nixzee/deco-pad-v1/deco-pad-v1/assembly/bom.xlsx

Designator | Package | Quantity | Designation | Part Number | Cost | Total by Board | Total | Link
R5 | R_0805_2012Metric | 1 | 1K | ERA-6AEB102V | $0.33 | $0.33 | $1.65 | https://www.digikey.com/product-detail/en/panasonic-electronic-components/ERA-6AEB102V/P1-0KDACT-ND/1465947
D18 | LED_0805_2012Metric | 1 | RED | LTST-C171KRKT | $0.28 | $0.28 | $1.40 | https://www.digikey.com/product-detail/en/lite-on-inc/LTST-C171KRKT/160-1427-1-ND/386800
U1 | QFN-44-1EP_7x7mm_P0.5mm_EP5.2x5.2mm | 1 | ATmega32U4-MU | ATMEGA32U4-MU | $3.98 | $3.98 | $19.90 | https://www.digikey.com/product-detail/en/microchip-technology/ATMEGA32U4-MU/ATMEGA32U4-MU-ND/1914603
J1 | PinSocket_2x03_P2.54mm_Vertical | 1 | AVR-ISP-6 | 67997-206HLF | $0.33 | $0.33 | $1.65 | https://www.digikey.com/product-detail/en/amphenol-icc-fci/67997-206HLF/609-3234-ND/1878491
R4,R3 | R_0805_2012Metric | 2 | 22 | ERJ-6GEYJ220V | $0.10 | $0.20 | $1.00 | https://www.digikey.com/product-detail/en/panasonic-electronic-components/ERJ-6GEYJ220V/P22ACT-ND/87316
R9,R8,R7,R6,R11,R10 | R_0805_2012Metric | 6 | 10K | ERA-6AEB103V | $0.33 | $1.98 | $9.90 | https://www.digikey.com/product-detail/en/panasonic-electronic-components/ERA-6AEB103V/P10KDACT-ND/1465971
D17,D16,D15,D14,D13,D12,D11,D10,D9,D8,D7,D6,D5,D4,D3,D2,D1 | D_SOD-123 | 17 | D_Small | 1N4148W-TP | $0.15 | $2.55 | $12.75 | https://www.digikey.com/product-detail/en/micro-commercial-co/1N4148W-TP/1N4148WTPMSCT-ND/717311
C2,C1 | C_0805_2012Metric | 2 | 0.01u | C0805C103J5RAC7210 | $0.10 | $0.20 | $1.00 | https://www.digikey.com/product-detail/en/kemet/C0805C103J5RAC7210/399-17616-1-ND/8572616
Y1 | Crystal_SMD_3225-4Pin_3.2x2.5mm | 1 | 16MHz | NX3225SA-16.000M-STD-CSR-1 | $0.75 | $0.75 | $3.75 | https://www.digikey.com/product-detail/en/ndk-america-inc/NX3225SA-16-000M-STD-CSR-1/644-1049-1-ND/1128921
USB1 | HRO-TYPE-C-31-M-12-HandSoldering | 1 | HRO-TYPE-C-31-M-12 | HRO-TYPE-C-31-M-12 | $0.99 | $0.99 | $4.95 | https://keeb.io/products/usb-c-port-12-pin-hro-type-c-31-m-12
SW2 | SW_SPST_B3S-1000 | 1 | SW_Push | B3S-1000P | $0.65 | $0.65 | $3.25 | https://www.digikey.com/product-detail/en/omron-electronics-inc-emc-div/B3S-1000P/SW836CT-ND/700012
SW1 | RotaryEncoder_Alps_EC11E-Switch_Vertical_H20mm | 1 | EC11 | PEC11L-4115F-S0020 | $2.34 | $2.34 | $11.70 | https://www.digikey.com/product-detail/en/bourns-inc/PEC11L-4115F-S0020/PEC11L-4115F-S0020-ND/4699168
R2,R1 | R_0805_2012Metric | 2 | 5.1K | ERA-6AEB512V | $0.33 | $0.66 | $3.30 | https://www.digikey.com/product-detail/en/panasonic-electronic-components/ERA-6AEB512V/P5-1KDACT-ND/1465964
F1 | Fuse_1206_3216Metric | 1 | 500mA | 0ZCJ0050AF2E | $0.19 | $0.19 | $0.95 | https://www.digikey.com/product-detail/en/bel-fuse-inc/0ZCJ0050AF2E/507-1803-1-ND/4156312
C11,C10 | C_0805_2012Metric | 2 | 20 | CL21B105KAFNNNE | $0.10 | $0.20 | $1.00 | https://www.digikey.com/product-detail/en/samsung-electro-mechanics/CL21B105KAFNNNE/1276-1066-1-ND/3889152
C9,C8,C7,C6,C5 | C_0805_2012Metric | 5 | 0.1u | CL21B104MBCNNNC | $0.10 | $0.50 | $2.50 | https://www.digikey.com/product-detail/en/samsung-electro-mechanics/CL21B104MBCNNNC/1276-2450-1-ND/3890536
C4,C3 | C_0805_2012Metric | 2 | 22p | CL21C220JB61PNC | $0.22 | $0.44 | $2.20 | https://www.digikey.com/product-detail/en/samsung-electro-mechanics/CL21C220JB61PNC/1276-2605-1-ND/3890691
 |  |  |  |  | Total | $16.57 | $82.85
