nixzee/deco-pad-v1/deco-pad-v1/assembly/deco-pad-v1.step

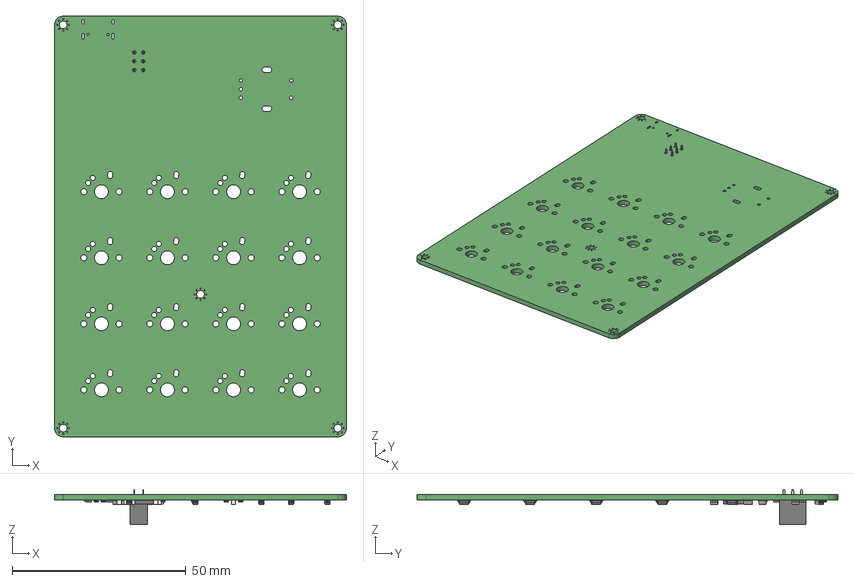
[picture p1: CAD file, 2020-07-16]
deco-pad-v1/assembly/deco-pad-v1.step
84.0 x 121.0 x 10.1 mm
