nixzee/deco-pad-v1/stl/case-top.stl

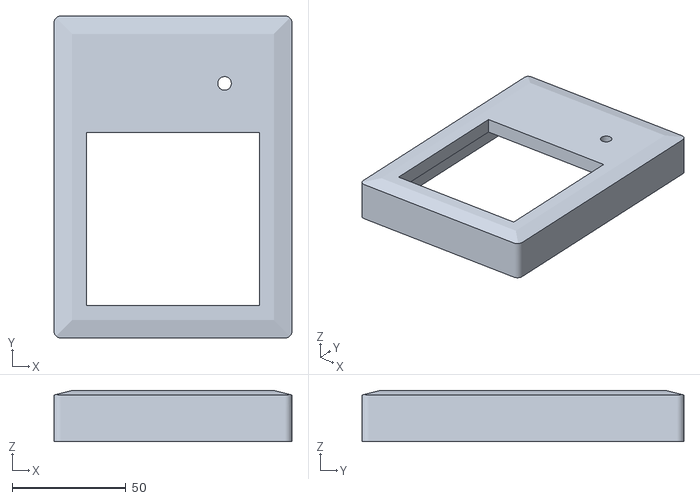
[picture p2: CAD file, 2020-07-27]
stl/case-top.stl
104.8 x 141.8 x 22.5
