nixzee/deco-pad-v1/stl/case-bottom.stl

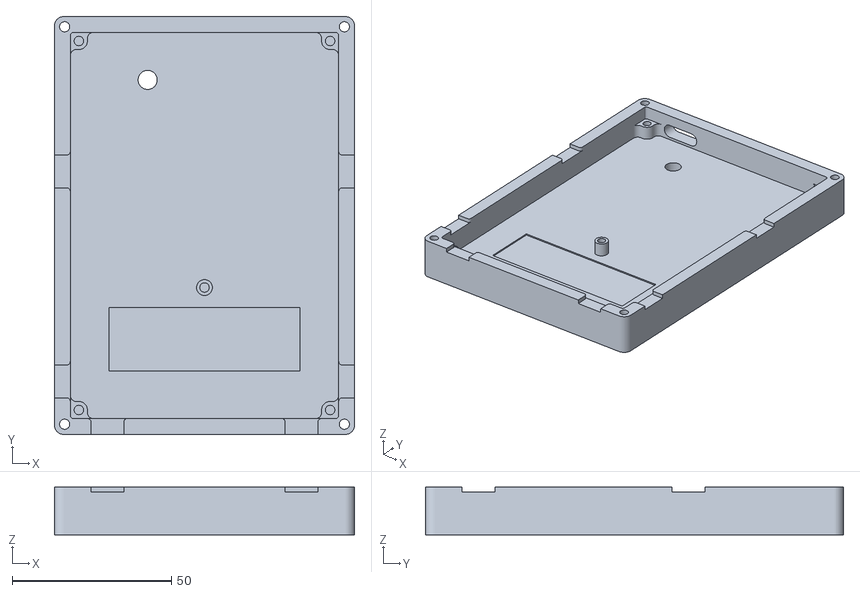
[picture p3: CAD file, 2020-07-27]
stl/case-bottom.stl
94.4 x 131.4 x 15.0
