nixzee/deco-pad-v1/stl/knob.stl

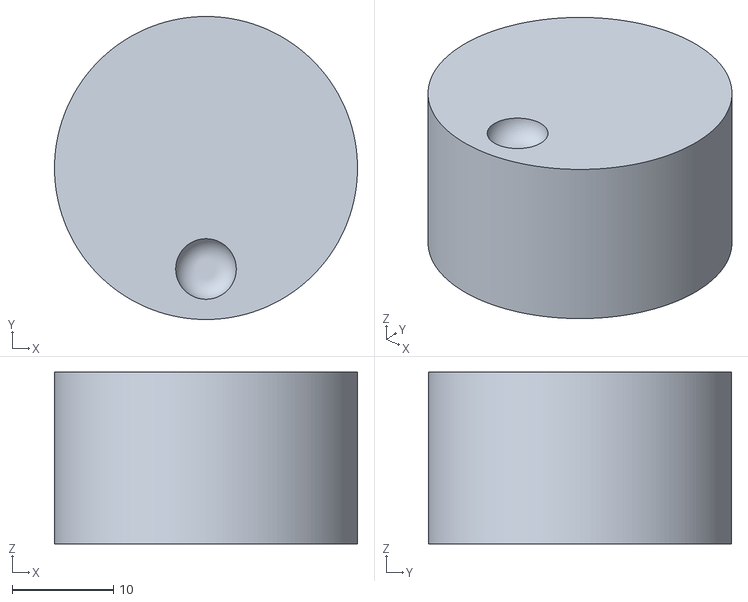
[picture p4: CAD file, 2020-07-27]
stl/knob.stl
30.0 x 30.0 x 17.0
