nixzee/deco-pad-v1/stl/plate.stl

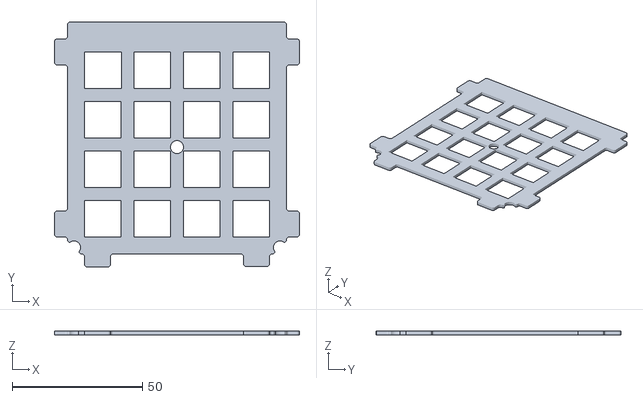
[picture p5: CAD file, 2020-07-27]
stl/plate.stl
94.0 x 94.0 x 1.50
