nixzee/deco-pad-v1/(list of files, cad)

Other CAD files:
stl/deco-pad-v1.stl
