nixzee/deco-pad-v1/deco-pad-v1/deco-pad-v1.kicad_pcb

## KiCad design deco-pad-v1/deco-pad-v1.kicad_pcb (2020-07-27)

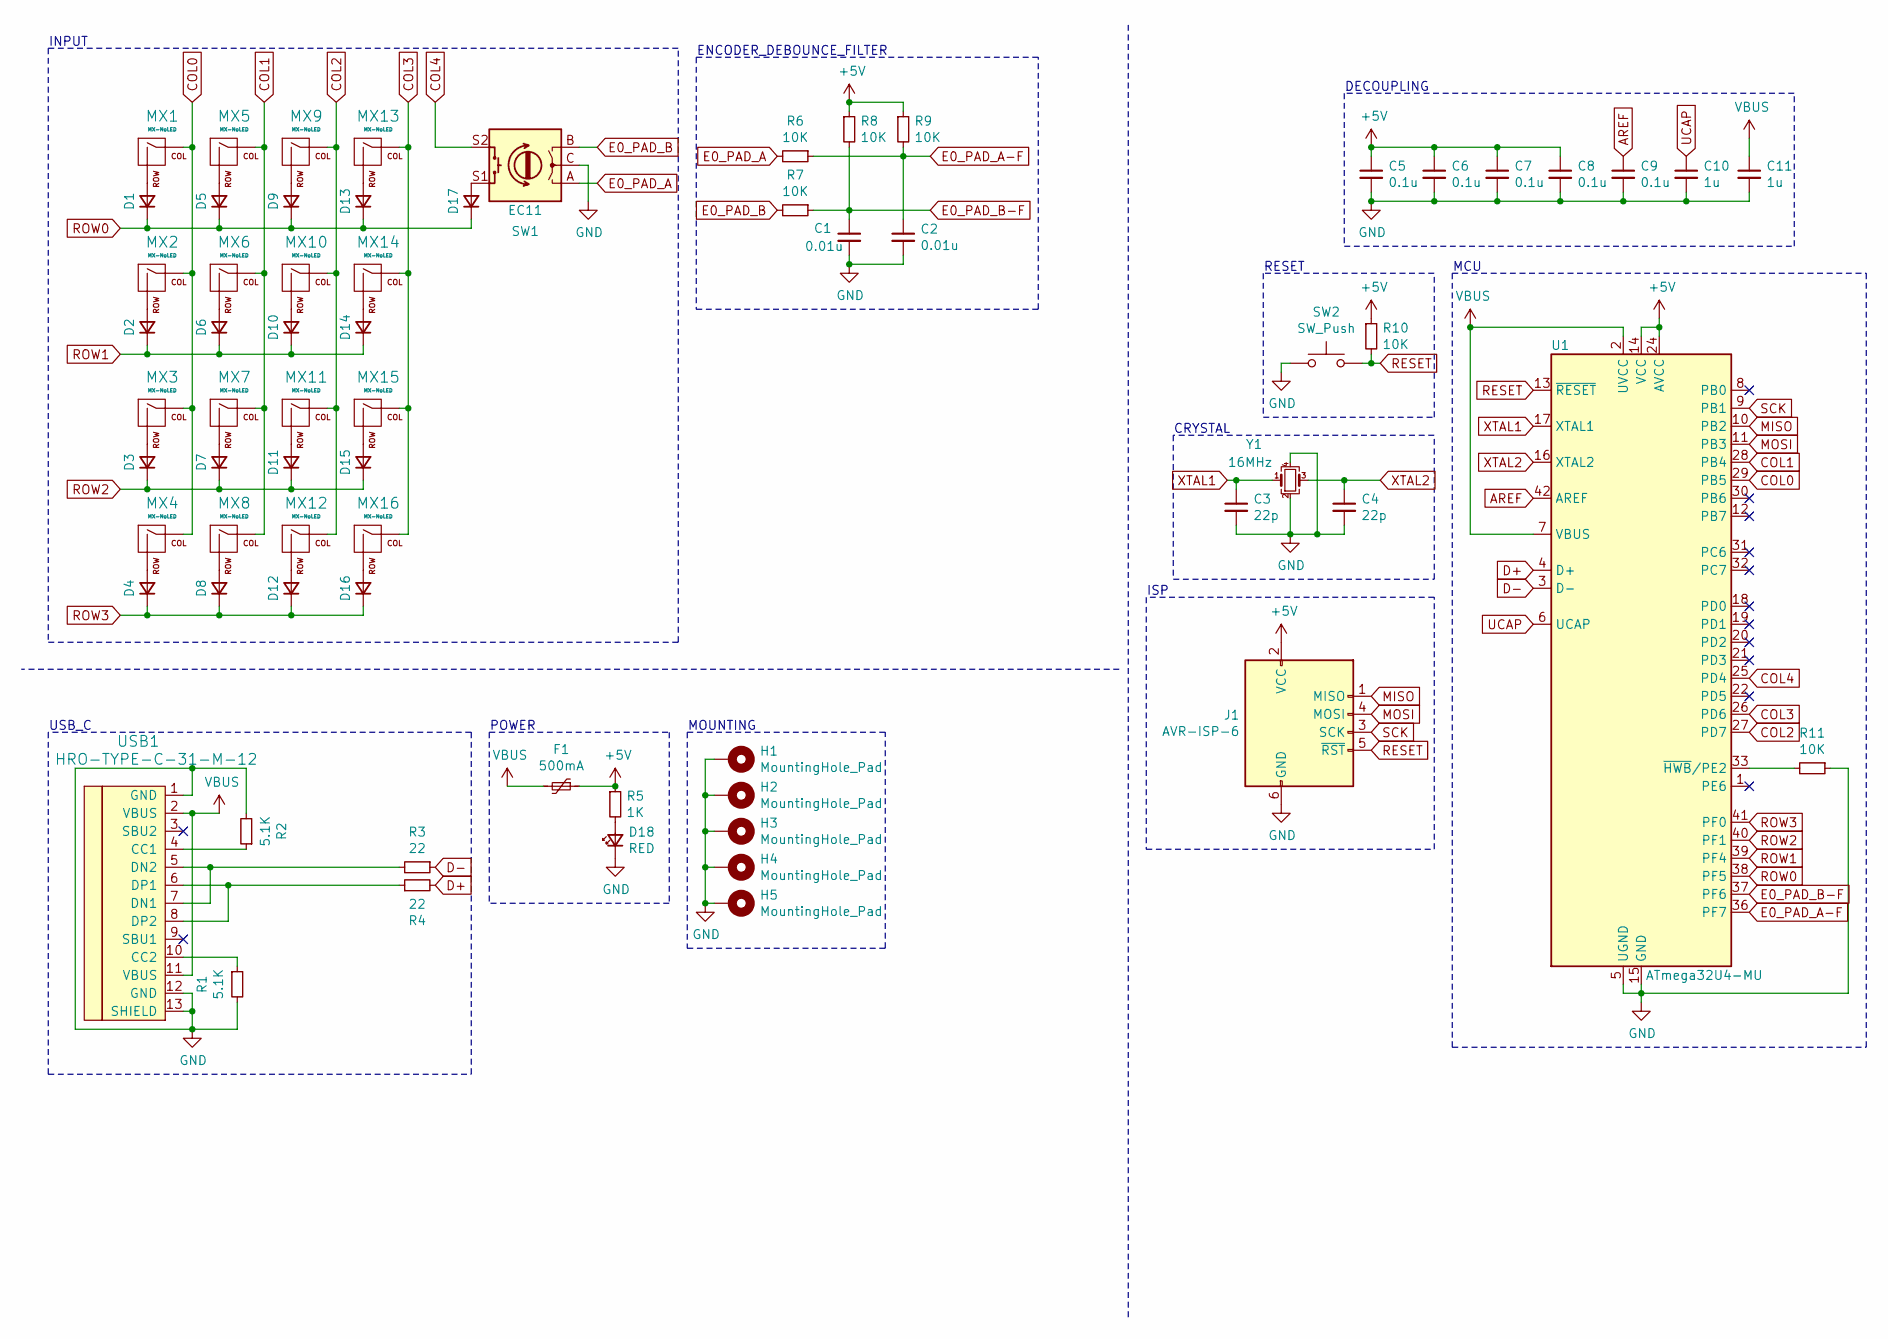
[picture p6: schematic deco-pad-v1.sch, Deco Pad V1]

Parts:
C1, C2: 0.01u; C_0805_2012Metric
C3, C4: 22p; C_0805_2012Metric
C5, C6, C7, C8, C9: 0.1u; C_0805_2012Metric
C10, C11: 1u; C_0805_2012Metric
D1, D2, D3, D4, D5, D6, D7, D8, D9, D10, D11, D12, D13, D14, D15, D16, D17: D_Small; D_SOD-123
D18: RED; LED_0805_2012Metric
F1: 500mA; Fuse_1206_3216Metric
H1, H2, H3, H4, H5: MountingHole_Pad; MountingHole_2.2mm_M2_Pad_Via
J1: AVR-ISP-6; PinSocket_2x03_P2.54mm_Vertical
MX1, MX2, MX3, MX4, MX5, MX6, MX7, MX8, MX9, MX10, MX11, MX12, MX13, MX14, MX15, MX16: MX-NoLED; MX-1U-NoLED
R1, R2: 5.1K; R_0805_2012Metric
R3, R4: 22; R_0805_2012Metric
R5: 1K; R_0805_2012Metric
R6, R7, R8, R9, R10, R11: 10K; R_0805_2012Metric
SW1: EC11; RotaryEncoder_Alps_EC11E-Switch_Vertical_H20mm
SW2: SW_Push; SW_SPST_B3S-1000
U1: ATmega32U4-MU; QFN-44-1EP_7x7mm_P0.5mm_EP5.2x5.2mm
USB1: HRO-TYPE-C-31-M-12; HRO-TYPE-C-31-M-12-HandSoldering
Y1: 16MHz; Crystal_SMD_3225-4Pin_3.2x2.5mm

Connections:
+5V: C5.1, C6.1, C7.1, C8.1, F1.1, J1.2 (VCC), R5.1, R8.1, R9.1, R10.1, U1.14 (VCC), U1.24 (AVCC), U1.34 (VCC), U1.44 (AVCC)
AREF: C9.1, U1.42 (AREF)
COL0: MX1.1 (COL), MX2.1 (COL), MX3.1 (COL), MX4.1 (COL), U1.29 (PB5)
COL1: MX5.1 (COL), MX6.1 (COL), MX7.1 (COL), MX8.1 (COL), U1.28 (PB4)
COL2: MX9.1 (COL), MX10.1 (COL), MX11.1 (COL), MX12.1 (COL), U1.27 (PD7)
COL3: MX13.1 (COL), MX14.1 (COL), MX15.1 (COL), MX16.1 (COL), U1.26 (PD6)
COL4: SW1.S2, U1.25 (PD4)
D+: R4.2, U1.4 (D+)
D-: R3.1, U1.3 (D-)
E0_PAD_A: R6.2, SW1.A
E0_PAD_A-F: C2.1, R6.1, R9.2, U1.36 (PF7)
E0_PAD_B: R7.2, SW1.B
E0_PAD_B-F: C1.1, R7.1, R8.2, U1.37 (PF6)
GND: C1.2, C2.2, C3.2, C4.2, C5.2, C6.2, C7.2, C8.2, C9.2, C10.2, C11.2, D18.1 (K), H1.1, H2.1, H3.1, H4.1, H5.1, J1.6 (GND), R1.2, R2.2, R11.1, SW1.C, SW2.1, U1.5 (UGND), U1.15 (GND), U1.23 (GND), U1.35 (GND), U1.43 (GND), U1.45 (GND), USB1.1 (GND), USB1.12 (GND), USB1.13 (SHIELD), Y1.2, Y1.4
MISO: J1.1 (MISO), U1.10 (PB2)
MOSI: J1.4 (MOSI), U1.11 (PB3)
unnamed: D1.2 (A), MX1.2 (ROW)
unnamed: D2.2 (A), MX2.2 (ROW)
unnamed: D3.2 (A), MX3.2 (ROW)
unnamed: D4.2 (A), MX4.2 (ROW)
unnamed: D5.2 (A), MX5.2 (ROW)
unnamed: D6.2 (A), MX6.2 (ROW)
unnamed: D7.2 (A), MX7.2 (ROW)
unnamed: D8.2 (A), MX8.2 (ROW)
unnamed: D9.2 (A), MX9.2 (ROW)
unnamed: D10.2 (A), MX10.2 (ROW)
unnamed: D11.2 (A), MX11.2 (ROW)
unnamed: D12.2 (A), MX12.2 (ROW)
unnamed: D13.2 (A), MX13.2 (ROW)
unnamed: D14.2 (A), MX14.2 (ROW)
unnamed: D15.2 (A), MX15.2 (ROW)
unnamed: D16.2 (A), MX16.2 (ROW)
unnamed: D17.2 (A), SW1.S1
unnamed: D18.2 (A), R5.2
unnamed: R1.1, USB1.10 (CC2)
unnamed: R2.1, USB1.4 (CC1)
unnamed: R3.2, USB1.5 (DN2), USB1.7 (DN1)
unnamed: R4.1, USB1.6 (DP1), USB1.8 (DP2)
unnamed: R11.2, U1.33 (~HWB~/PE2)
RESET: J1.5 (~RST), R10.2, SW2.2, U1.13 (~RESET)
ROW0: D1.1 (K), D5.1 (K), D9.1 (K), D13.1 (K), D17.1 (K), U1.38 (PF5)
ROW1: D2.1 (K), D6.1 (K), D10.1 (K), D14.1 (K), U1.39 (PF4)
ROW2: D3.1 (K), D7.1 (K), D11.1 (K), D15.1 (K), U1.40 (PF1)
ROW3: D4.1 (K), D8.1 (K), D12.1 (K), D16.1 (K), U1.41 (PF0)
SCK: J1.3 (SCK), U1.9 (PB1)
UCAP: C10.1, U1.6 (UCAP)
VBUS: C11.1, F1.2, U1.2 (UVCC), U1.7 (VBUS), USB1.2 (VBUS), USB1.11 (VBUS)
XTAL1: C3.1, U1.17 (XTAL1), Y1.1
XTAL2: C4.1, U1.16 (XTAL2), Y1.3

Notes on the sheet:
MCU
CRYSTAL
ENCODER_DEBOUNCE_FILTER
INPUT
USB_C
RESET
ISP
DECOUPLING
MOUNTING
POWER

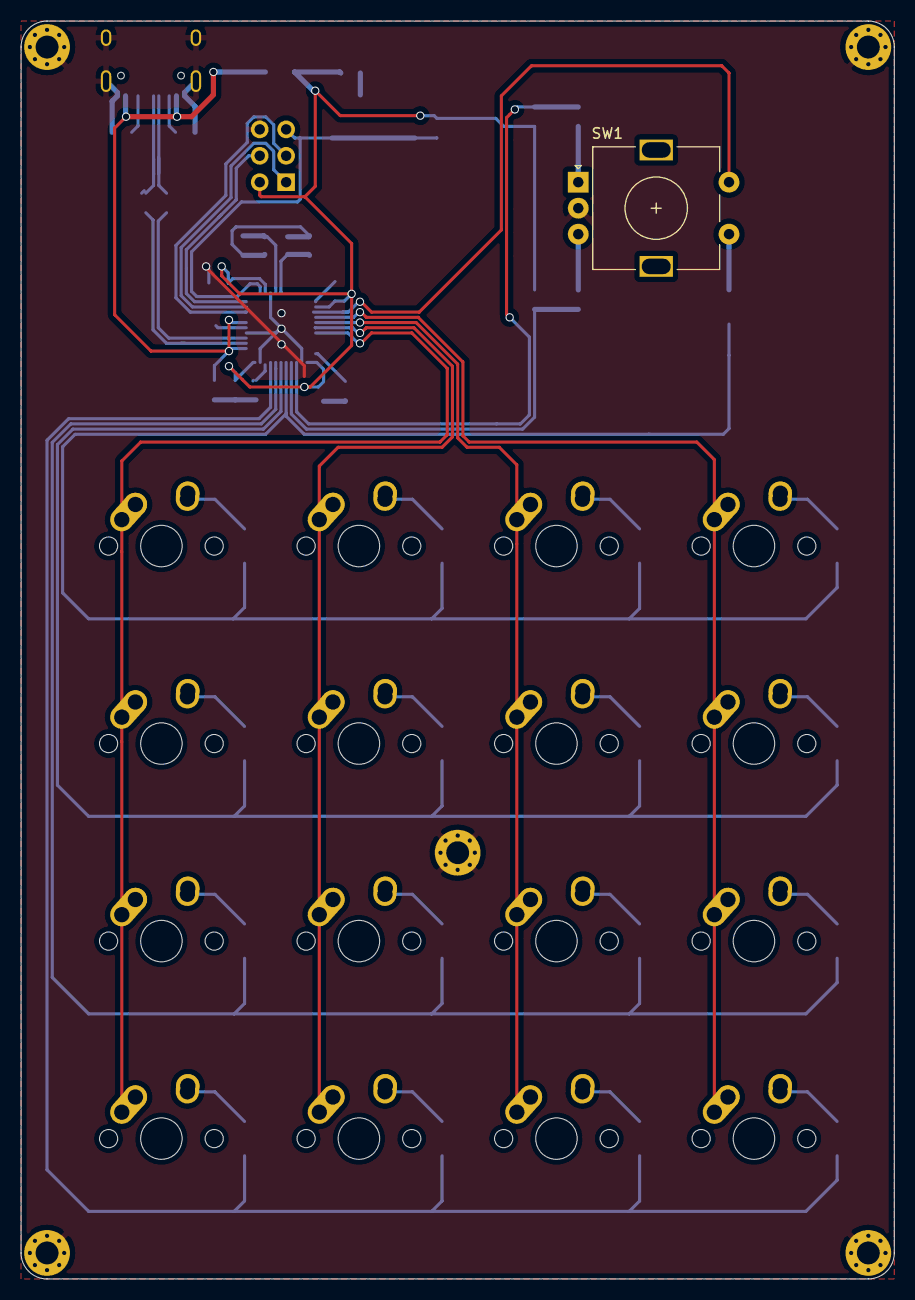
[picture p7: board deco-pad-v1.kicad_pcb from above]

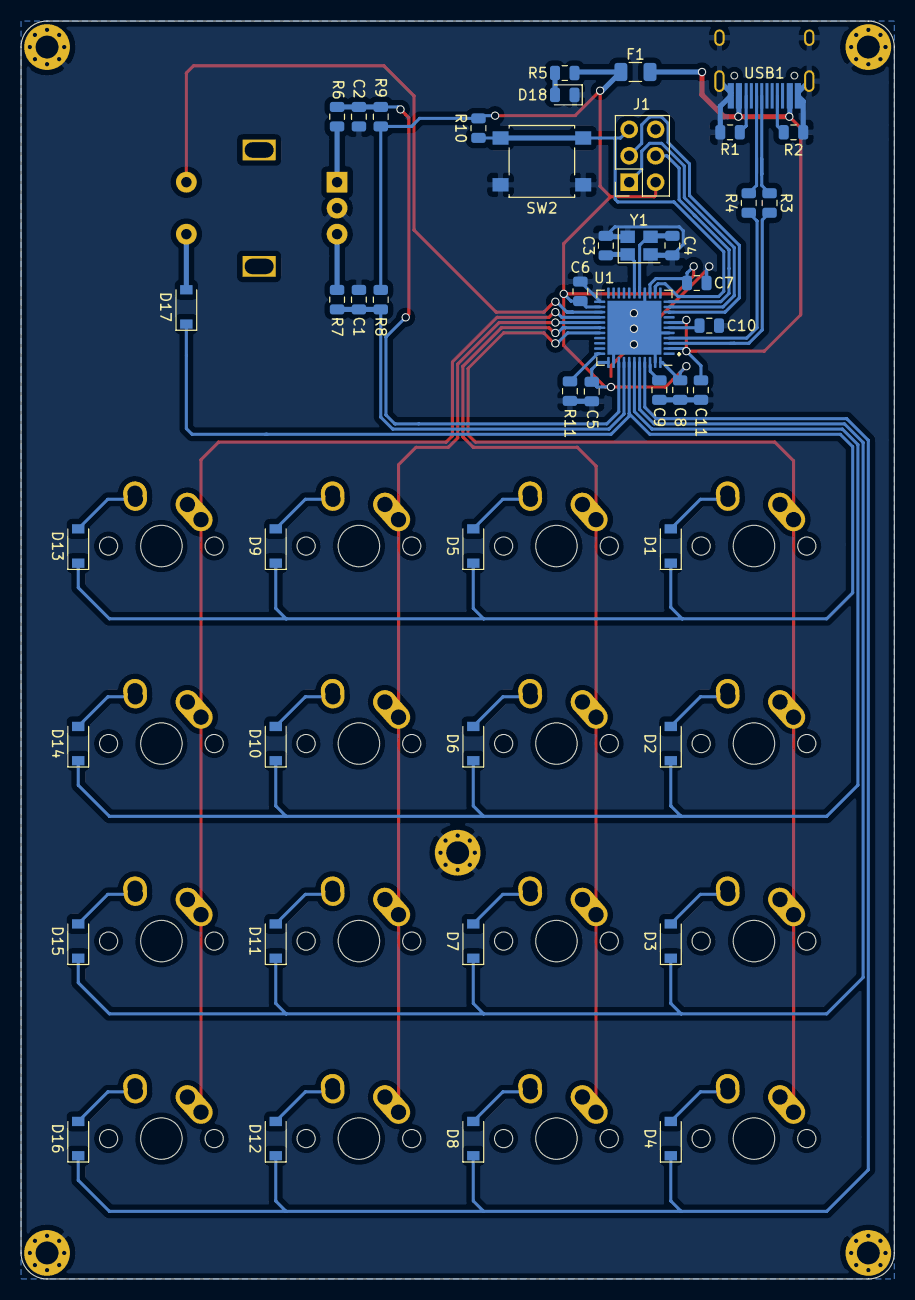
[picture p8: board deco-pad-v1.kicad_pcb from below]

Board: 2 copper layers, 84.0 x 121.0 mm, 68 parts (46 on the bottom side), 49 nets.
