nixzee/deco-pad-v1/(commit log)

2020-07-14 [NZ] Init commit
    [deco-pad-v1.kicad_pcb, deco-pad-v1.sch]
2020-07-14 [NZ] Almost completed on schematic and choosing footprints.
    [deco-pad-v1.sch]
2020-07-15 [NZ] Schematic and Footprints done.
    [deco-pad-v1.sch]
2020-07-15 [NZ] Components are in relative on the pcb layout.
    [deco-pad-v1.sch]
2020-07-15 [NZ] Still staging
    [deco-pad-v1.kicad_pcb, deco-pad-v1.sch]
2020-07-15 [NZ] PCB ready for review
    [deco-pad-v1-B_Cu.gbr, deco-pad-v1-B_Mask.gbr, deco-pad-v1-B_Paste.gbr, deco-pad-v1-B_SilkS.gbr, deco-pad-v1-Edge_Cuts.gbr, deco-pad-v1-F_Cu.gbr, deco-pad-v1-F_Mask.gbr, deco-pad-v1-F_Paste.gbr]
2020-07-15 [NZ] Cleaned up the schematic.
    [deco-pad-v1.sch]
2020-07-16 [NZ] Adjusted Rotary Encoder.
    [deco-pad-v1-B_Cu.gbr, deco-pad-v1-B_Mask.gbr, deco-pad-v1-B_Paste.gbr, deco-pad-v1-B_SilkS.gbr, deco-pad-v1-Edge_Cuts.gbr, deco-pad-v1-F_Cu.gbr, deco-pad-v1-F_Mask.gbr, deco-pad-v1-F_Paste.gbr]
2020-07-16 [NZ] Added Zip of gerber
    [deco-pad-v1.step]
2020-07-27 [NZ] Removed ESD while research a backup. Remove schottky since not needed and would drop the voltage too much. Some cleanup. Will add silk art and curved tracks next.
    [case-bottom.stl, case-top.stl, deco-pad-v1.kicad_pcb, deco-pad-v1.sch, deco-pad-v1.stl, knob.stl, plate.stl]
2020-09-09 [NZ] Regenerate gerber and drill file for JCL. Completed BOM and ordered parts.
    [bom.xlsx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]
